Deerczl/MainBoard-Pro-Mini/(list of files, drawings)

Other design files:
SCH & PCB/MainBoard Pro Mini.PrjPcb
SCH & PCB/MainBoard Pro Mini.SchDoc
SCH & PCB/MainBoard Pro Mini_2.SchDoc
